SteelAndWater/temperature_survey/docs/prototype.jpg

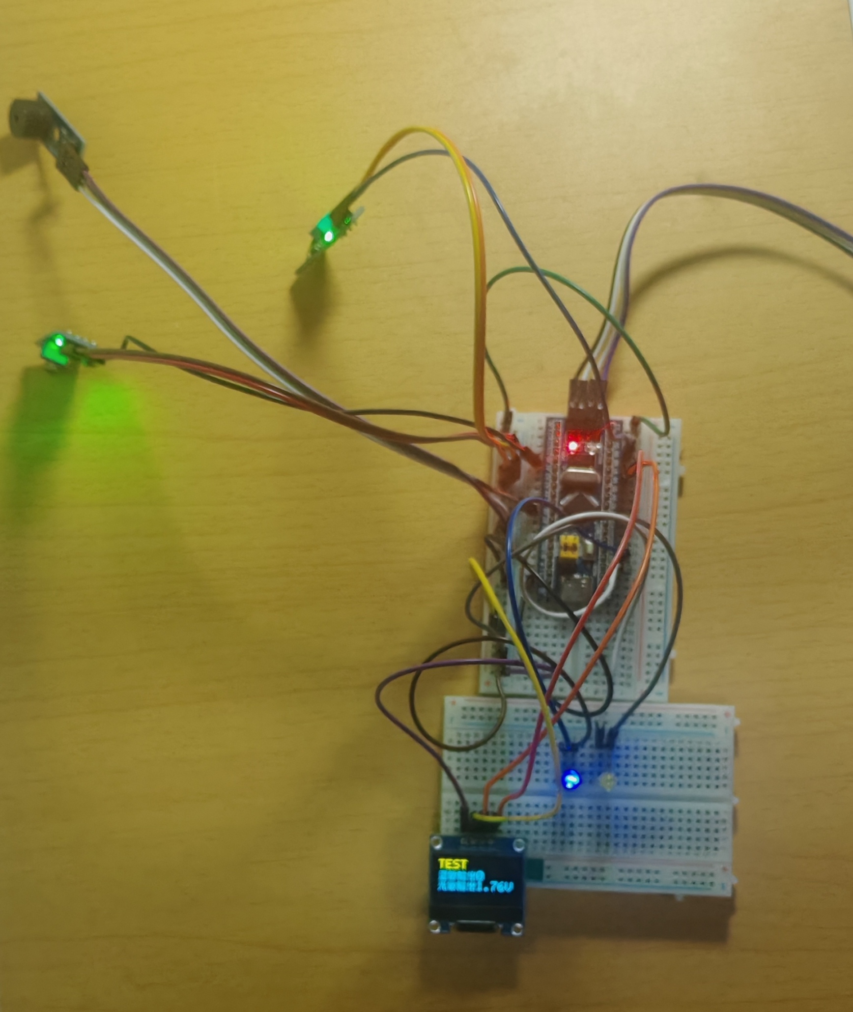
docs/prototype.jpg
